maverstr/PS2-Motion-Sensor/Solidworks/mouseHolderAssembly.sldasm

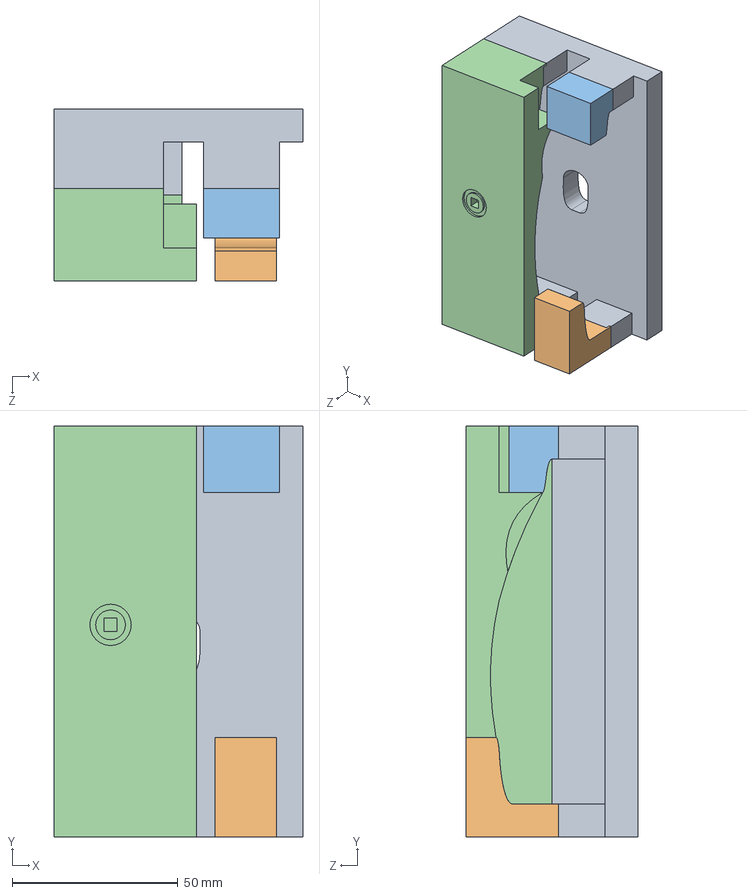
[picture p1: CAD file, 2019-09-16]
Solidworks/mouseHolderAssembly.sldasm
75.0 x 124.0 x 52.0 mm
Lip&Groove3-Groove
Lip&Groove2-Lip
Lip&Groove1-Lip
Lip&Groove3-Lip
