maverstr/PS2-Motion-Sensor/Solidworks/mouseHolderSpot.SLDPRT

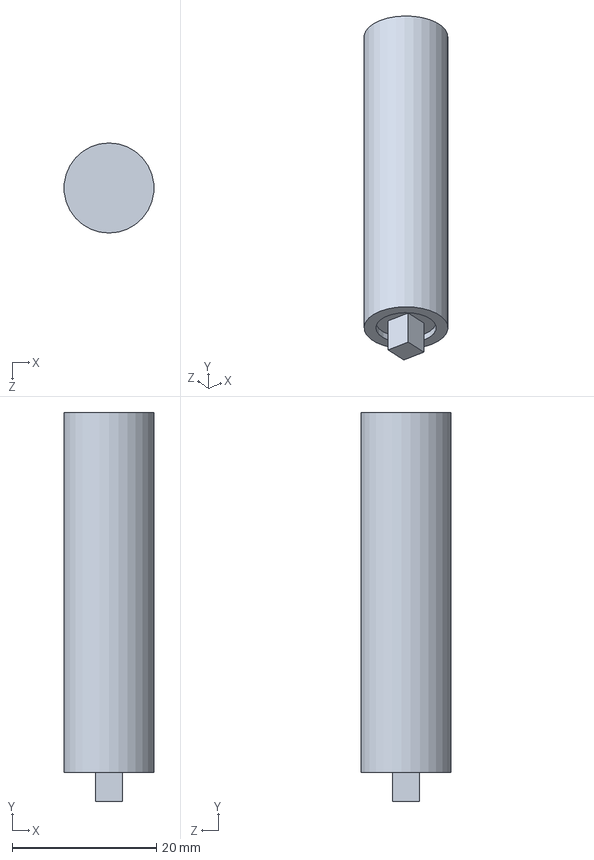
[picture p2: CAD file, 2019-09-16]
Solidworks/mouseHolderSpot.SLDPRT
12.4 x 54.0 x 12.5 mm
