maverstr/PS2-Motion-Sensor/Solidworks/forwardBlocker.sldprt

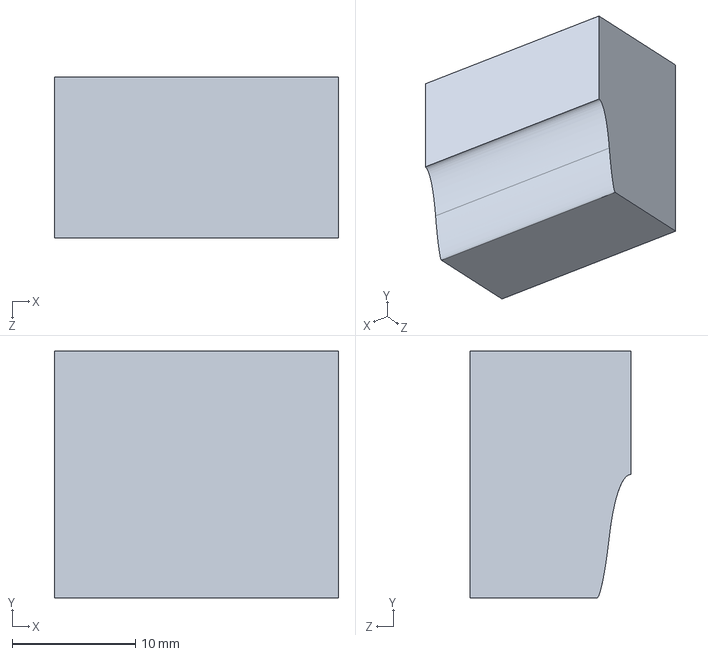
[picture p3: CAD file, 2019-09-16]
Solidworks/forwardBlocker.sldprt
23.0 x 20.0 x 13.0 mm
