maverstr/PS2-Motion-Sensor/Solidworks/mouseHolderV2/mouseHolderV2.SLDPRT

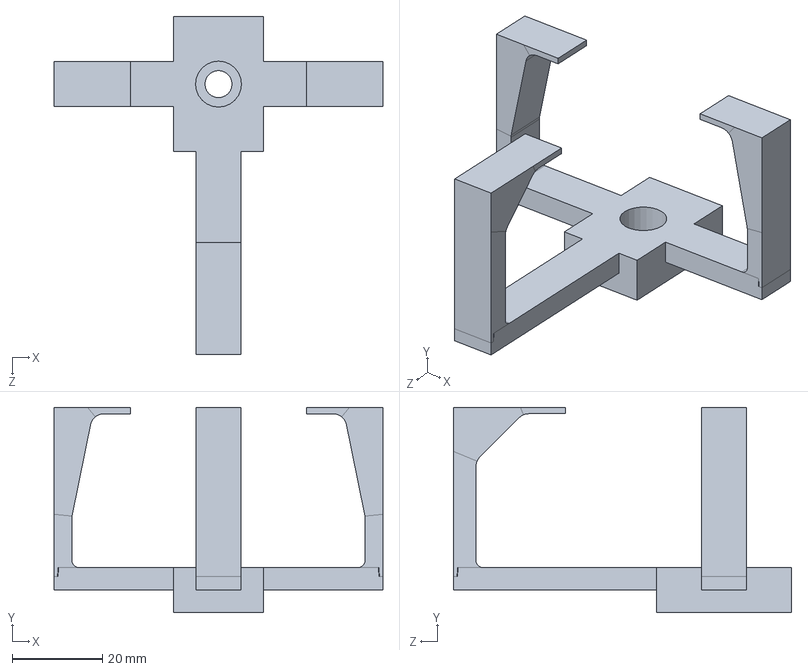
[picture p4: CAD file, 2019-09-16]
Solidworks/mouseHolderV2/mouseHolderV2.SLDPRT
73.0 x 45.5 x 75.0 mm
