maverstr/PS2-Motion-Sensor/Solidworks/mouseHolderV2/mouseHolderV2_base.SLDPRT

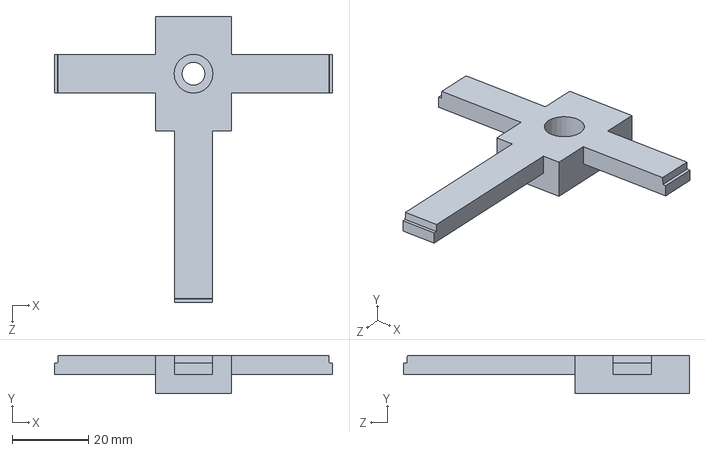
[picture p5: CAD file, 2019-09-16]
Solidworks/mouseHolderV2/mouseHolderV2_base.SLDPRT
73.0 x 10.0 x 75.0 mm
