maverstr/PS2-Motion-Sensor/Solidworks/topBlocker.sldprt

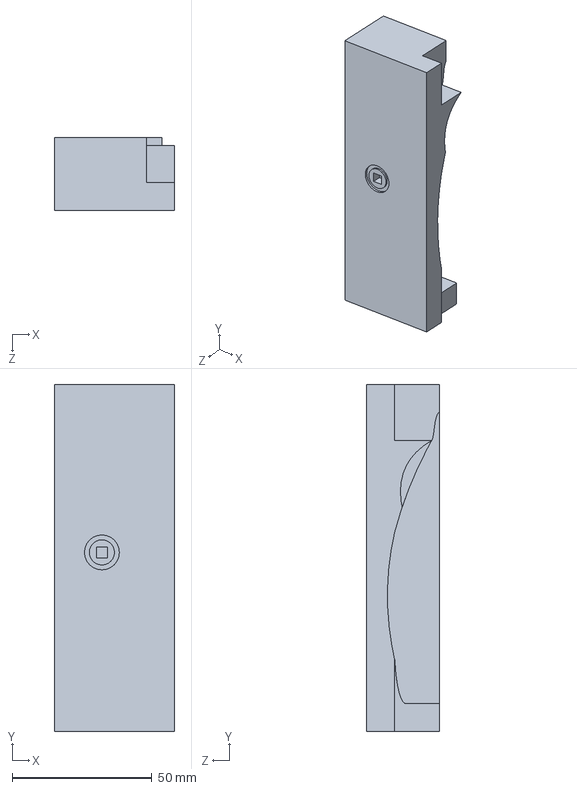
[picture p6: CAD file, 2019-09-16]
Solidworks/topBlocker.sldprt
43.0 x 124.0 x 26.0 mm
