maverstr/PS2-Motion-Sensor/Solidworks/Lip&Groove2-Lip.sldprt

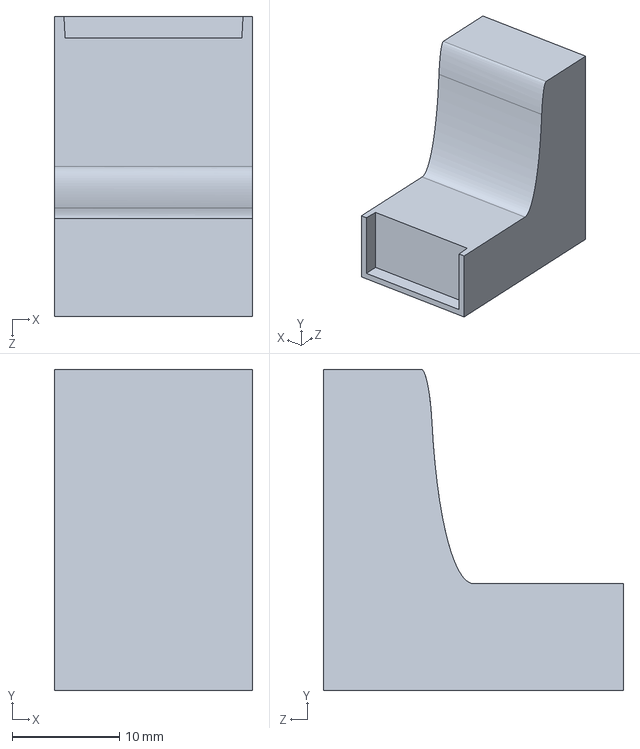
[picture p7: CAD file, 2019-09-16]
Solidworks/Lip&Groove2-Lip.sldprt
18.5 x 30.0 x 28.0 mm
