maverstr/PS2-Motion-Sensor/Solidworks/backwardBlocker.sldprt

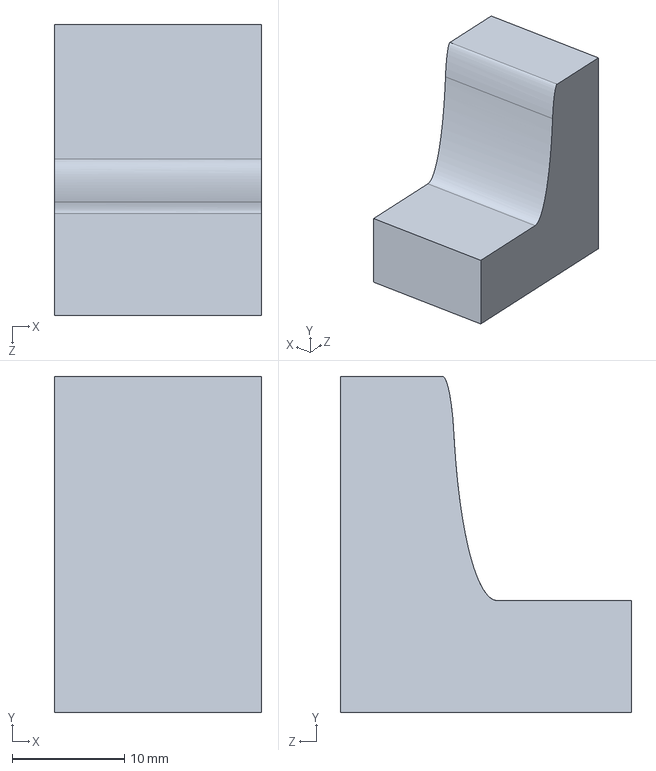
[picture p8: CAD file, 2019-09-16]
Solidworks/backwardBlocker.sldprt
18.5 x 30.0 x 26.0 mm
