maverstr/PS2-Motion-Sensor/Solidworks/Lip&Groove3-Groove.sldprt

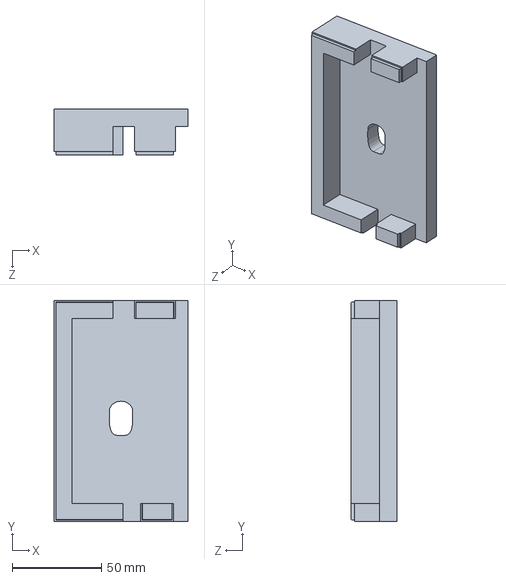
[picture p9: CAD file, 2019-09-16]
Solidworks/Lip&Groove3-Groove.sldprt
75.0 x 124.0 x 26.0 mm
