maverstr/PS2-Motion-Sensor/Solidworks/Lip&Groove3-Lip.sldprt

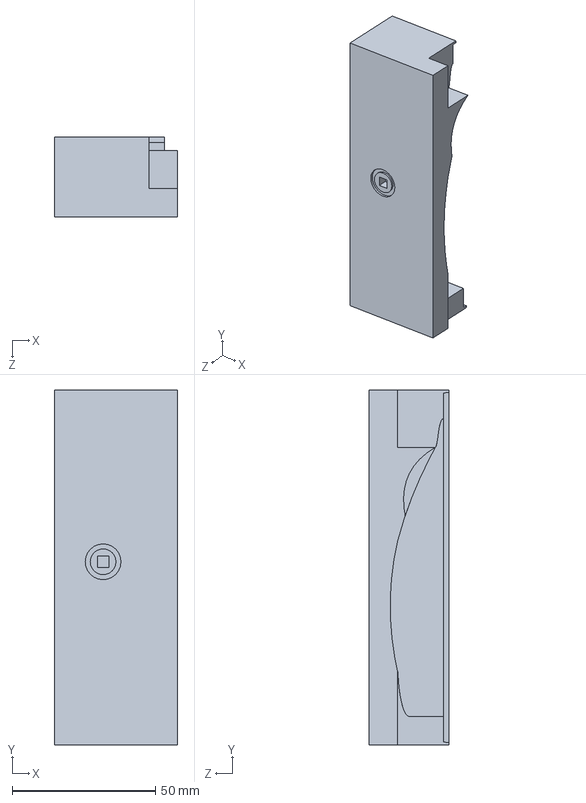
[picture p10: CAD file, 2019-09-16]
Solidworks/Lip&Groove3-Lip.sldprt
43.0 x 124.0 x 28.0 mm
