maverstr/PS2-Motion-Sensor/Solidworks/Base.sldprt

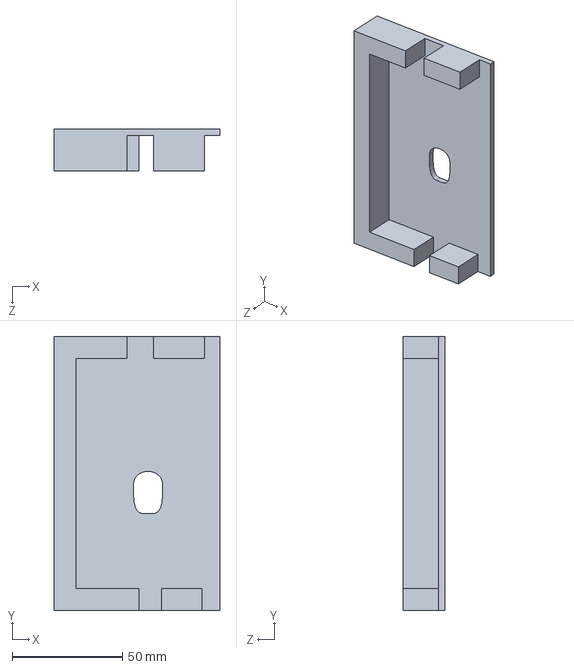
[picture p11: CAD file, 2019-09-16]
Solidworks/Base.sldprt
75.0 x 124.0 x 19.0 mm
