maverstr/PS2-Motion-Sensor/Solidworks/Lip&Groove1-Lip.sldprt

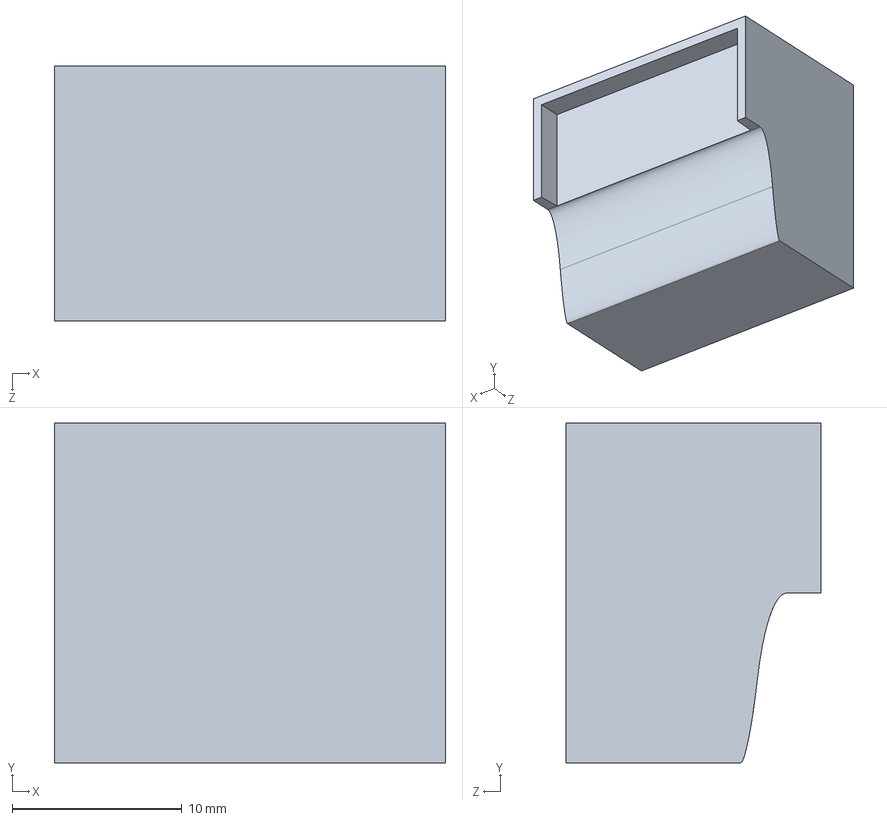
[picture p12: CAD file, 2019-09-16]
Solidworks/Lip&Groove1-Lip.sldprt
23.0 x 20.0 x 15.0 mm
