maverstr/PS2-Motion-Sensor/(list of files, cad)

Other CAD files:
Solidworks/mouseHolderV2/mouseHolderV2_backwardBlocker.SLDPRT
Solidworks/mouseHolderV2/mouseHolderV2_leftBlocker.SLDPRT
Solidworks/mouseHolderV2/mouseHolderV2_rightBlocker.SLDPRT
Solidworks/mouseHolder.SLDPRT
Solidworks/STL/Base.STL
Solidworks/STL/backwardBlocker.STL
Solidworks/STL/forwardBlocker.STL
Solidworks/STL/mouseHolderSpot.STL
Solidworks/STL/topBlocker.STL
Solidworks/mouseHolder.STL
Solidworks/mouseHolderV2/STL/mouseHolderV2_backwardBlocker.STL
Solidworks/mouseHolderV2/STL/mouseHolderV2_base.STL
Solidworks/mouseHolderV2/STL/mouseHolderV2_leftBlocker.STL
Solidworks/mouseHolderV2/STL/mouseHolderV2_rightBlocker.STL
