maverstr/PS2-Motion-Sensor/PS2Mouse/PS2Mouse.ino

/*
  PS2 Pinout
  1 : Data
  3 : GND
  4 : VCC
  5 : CLK
*/

//representation : mouse moves x and y from normal view -> 2D polar coordinates (r = sqrt(x²+y²), theta = atan(y/x))
// mouse turns around = phi -> angular offset of polar in its reference

#include "PS2Mouse.h"
#include "coordinates.h"

#define PITCH 0.00318 //resolution in cm of the optical mouse
              // we can get an 8-bit (127 values) per communication. 
              //max speed therefore depends on communication speed -> oscilloscope clock 12.85kHz, actual data rate in this code: 59Hz
              // max speed = 59*127*0.00318 = 24cm/sec

PS2Mouse mouse(6, 5); //clk, data
PS2Mouse mouse2(3, 2); //clk data for mouse 2

float posx = 0;
float posy = 0;
float posy2 = 0;
float posz = 0;

float previousx = posx;
float previousy = posy;
float previousy2 = posy2;
float previousz = posz;

float vector[2];

int x, y, z, z2;

bool rotation = true;
bool polar = false;

Coordinates polarCoord = Coordinates();

void setup() {
  Serial.begin(500000);
  while (!Serial);
  Serial.print("Motion sensor Setup...");
  mouse.begin();
  mouse2.begin();
  Serial.println("complete!");
}

void loop() {
  uint8_t stat, stat2;
  mouse.getPosition(stat, x, z);
  mouse2.getPosition(stat2, y, z2);
  
  previousx = posx;
  previousy = posy;
  previousz = posz;

  posz = previousz + (float)z;

  if (rotation) {
    toVector(x, y, posz); //rotation of x and y depending on z reference
    x = vector[0];
    y = vector[1];
  }
  posx = previousx + (float)x;
  posy = previousy + (float)y;
  
  Serial.print(posx);
  Serial.print(" ");
  Serial.print(-posy);
  Serial.print(" ");
  Serial.print(posz);
  Serial.print(" ");
  Serial.println("end");

/*
  Serial.print("distance parcourue : ");
  Serial.println(PITCH*posx);
*/

  if (polar) {
    //go from cart to polar coordinates
    polarCoord.fromCartesian(x, y);
    /*
    Serial.print("polar coord : ");
    Serial.print(polarCoord.getR());
    Serial.print(" ");
    Serial.println(polarCoord.getAngle() * (360 / (2 * PI)));
  */
  }
}


void toVector(float x, float y, float z) {
  //rotates the vector around the z axis to follow the path
  float rotatedX = (float) (x * cos((z / 13000)*2*PI) - y * sin((z / 13000)*2*PI)); //one full ball rotation = 13000
  float rotatedY = (float) (x * sin((z / 13000)*2*PI) + y * cos((z / 13000)*2*PI));
  float rotatedVector[2];
  vector[0] = rotatedX;
  vector[1] = rotatedY;
}
